hridaKun/esp32-fluorimeter/Simulation/Outputs/1_dc_transfer.png

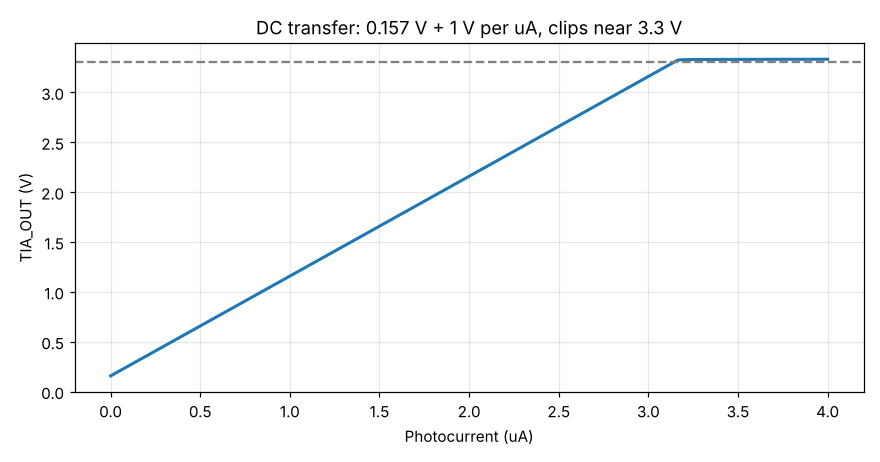
Simulation/Outputs/1_dc_transfer.png
