hridaKun/esp32-fluorimeter/Simulation/Outputs/2_led_pulse.png

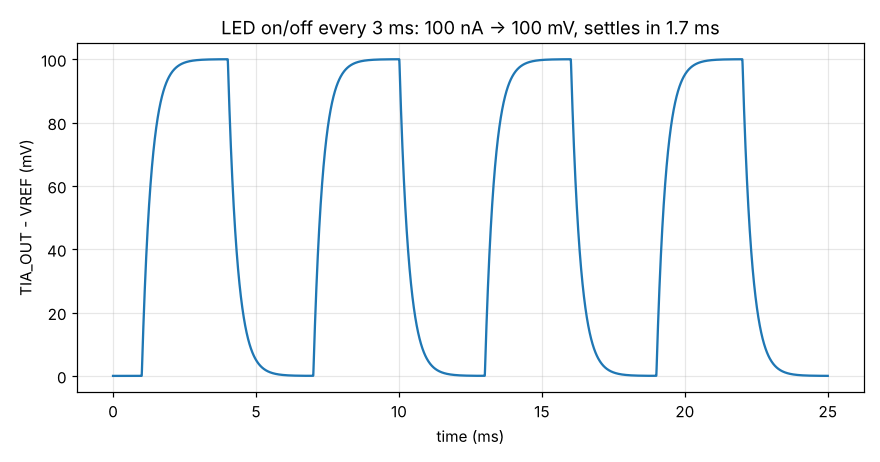
Simulation/Outputs/2_led_pulse.png
