hridaKun/esp32-fluorimeter/Simulation/Outputs/3_stability_noCf.png

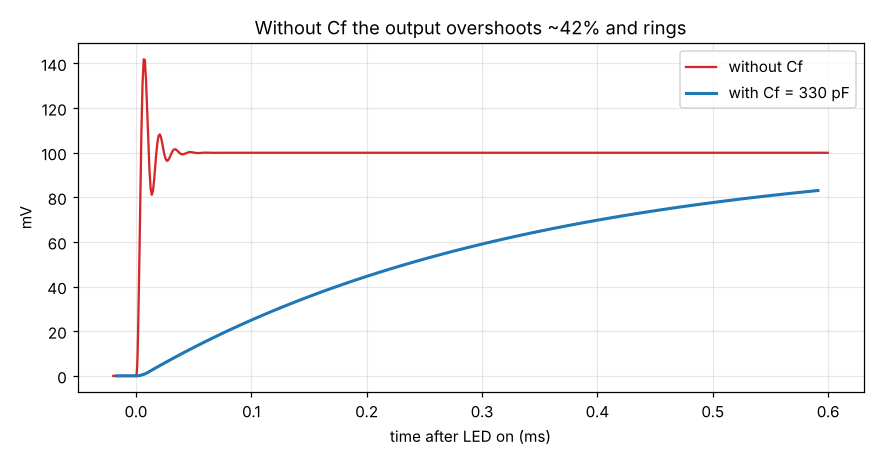
Simulation/Outputs/3_stability_noCf.png
