hridaKun/esp32-fluorimeter/docs/BOM.md

# Bill of Materials

| Ref | Qty | Part | Value / Type |
|---|---|---|---|
| U1 | 1 | ESP32 DevKit | 38-pin |
| U2 | 1 | Op-amp | MCP602, DIP-8 (with socket) |
| U3 | 1 | ADC module | ADS1115 breakout |
| J1 | 1 | Display | 2.4" ILI9341 SPI TFT |
| D1 | 1 | Photodiode | Vishay BPW34 |
| D2 | 1 | LED | Blue, 5 mm, ~470 nm |
| Q1 | 1 | NPN transistor | BC547 (C-B-E) |
| R1 | 1 | Resistor | 20 kΩ |
| R2 | 1 | Resistor | 1 kΩ |
| R3 | 1 | Resistor (Rf) | 1 MΩ, 1 % |
| R4 | 1 | Resistor | 100 Ω |
| R5 | 1 | Resistor | 1 kΩ |
| C1 | 1 | Capacitor | 10 µF |
| C2 | 1 | Capacitor (Cf) | 330 pF C0G (or 220 pF + 100 pF) |
| C3 | 1 | Capacitor | 100 nF ceramic |
| SW1, SW2 | 2 | Push button | 6 mm tactile |
| — | 1 | Emission filter | long-pass green/yellow (gel or glass) |
| — | — | Cuvettes | 10 mm, plastic |
| — | — | Test fluorophore | fluorescein sodium |
| — | — | Misc | female headers, breadboard/perfboard, wires |
