hridaKun/esp32-fluorimeter/Schematic/Circuit.pdf

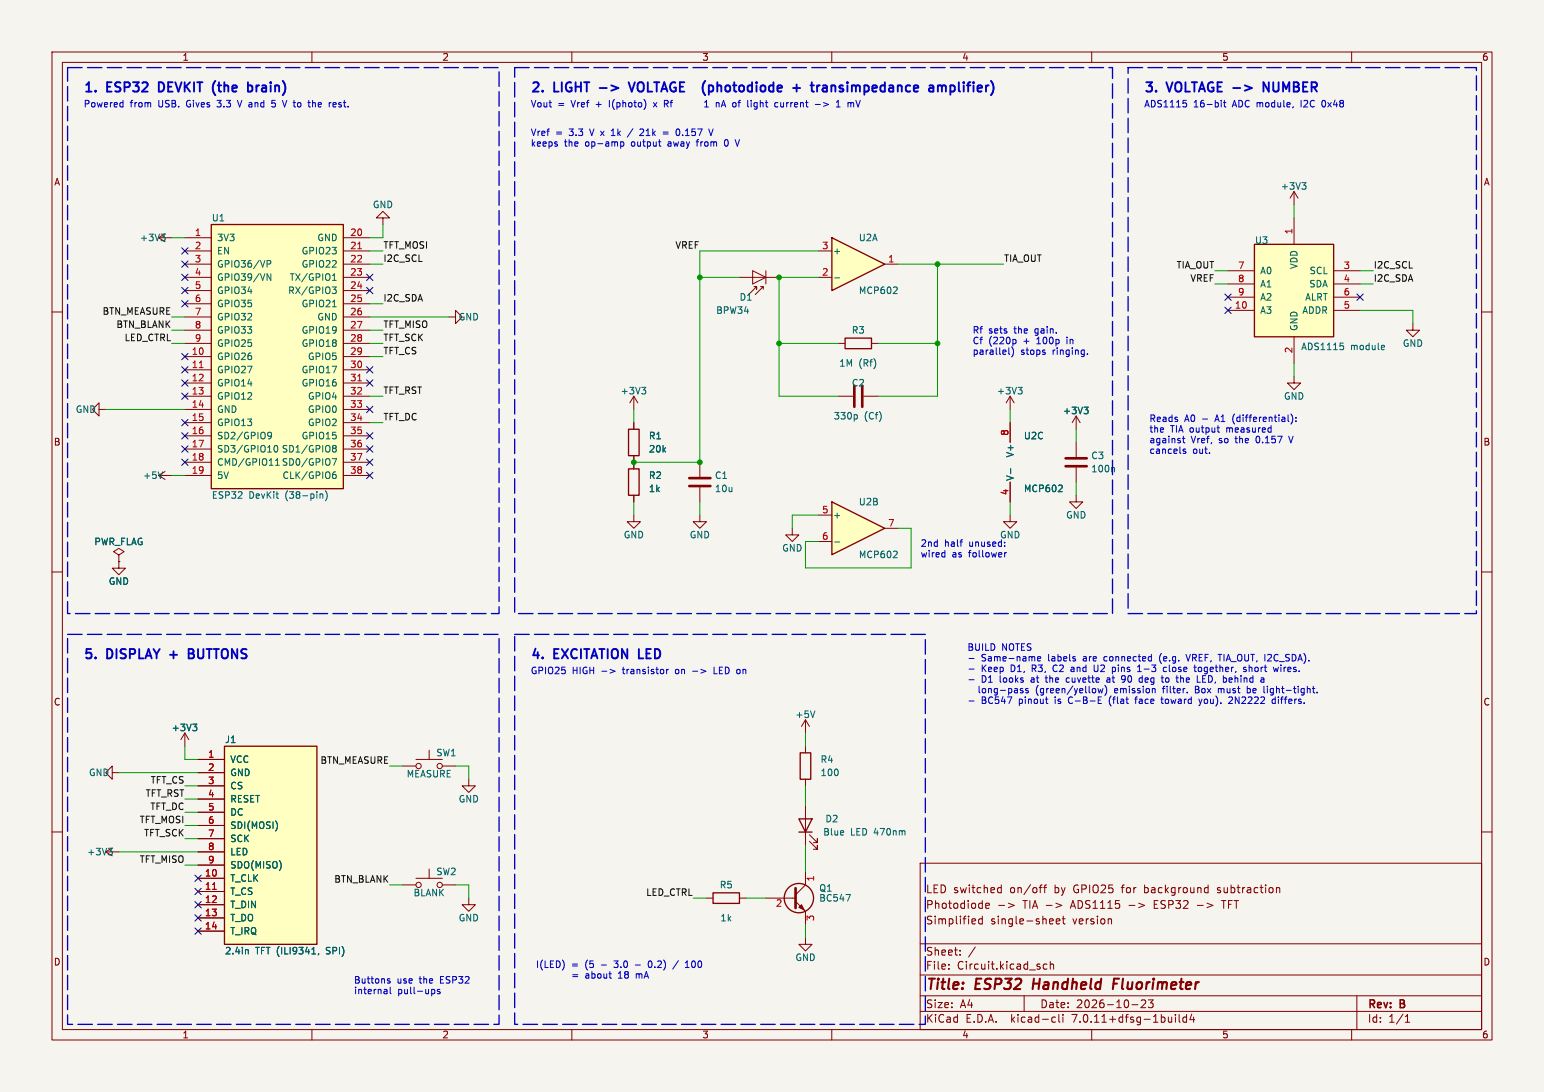
[picture p6: page 1]

2 SCL 3 SDA 4 ADDR 5 ALRT 6 A0 7 A1 8 A2 9 U3 ADS1115 module +3V3 VCC 1 T_CLK 10 T_CS 11 T_DIN 12 T_DO 13 T_IRQ 14 GND 2 CS 3 RESET 4 DC 5 SDI(MOSI) 6 SCK 7

2nd half unused: wired as follower Rf sets the gain. Cf (220p + 100p in

the TIA output measured
against Vref, so the 0.157 V
