hridaKun/esp32-fluorimeter/Schematic/Circuit.kicad_sch

## KiCad design Schematic/Circuit.kicad_sch (2026-10-23)

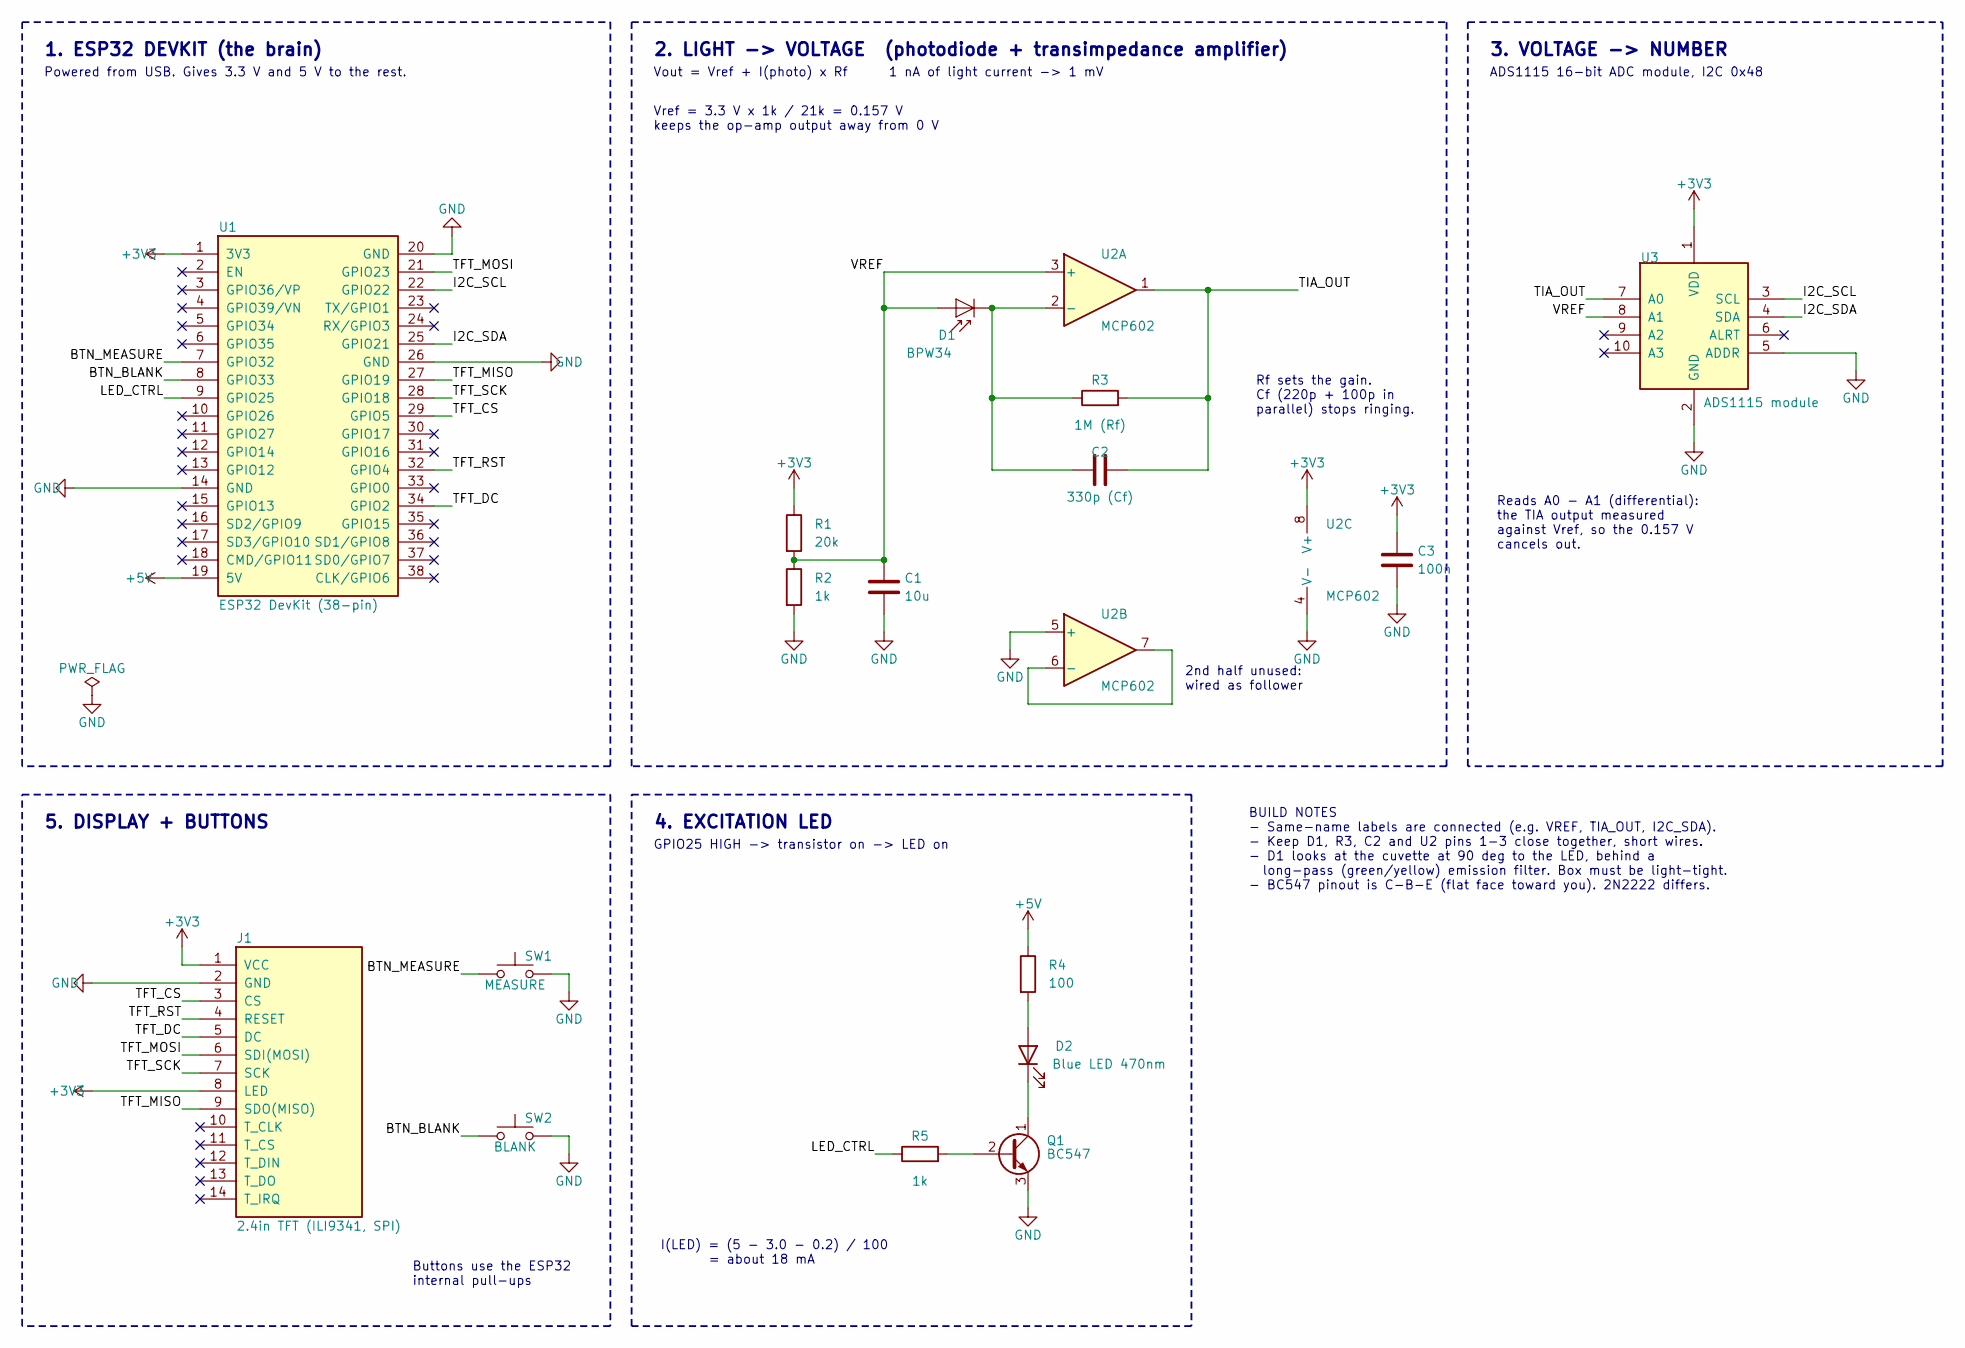
[picture p7: schematic Circuit.kicad_sch]

Parts:
C1: 10u; CP_Radial_D5.0mm_P2.00mm
C2: 330p (Cf); C_Disc_D5.0mm_W2.5mm_P5.00mm
C3: 100n; C_Disc_D5.0mm_W2.5mm_P5.00mm
D1: BPW34; Osram_DIL2_4.3x4.65mm_P5.08mm
D2: Blue LED 470nm; LED_D5.0mm
J1: 2.4in TFT (ILI9341, SPI)
Q1: BC547; TO-92_Inline
R1: 20k; R_Axial_DIN0207_L6.3mm_D2.5mm_P7.62mm_Horizontal
R2, R5: 1k; R_Axial_DIN0207_L6.3mm_D2.5mm_P7.62mm_Horizontal
R3: 1M (Rf); R_Axial_DIN0207_L6.3mm_D2.5mm_P7.62mm_Horizontal
R4: 100; R_Axial_DIN0207_L6.3mm_D2.5mm_P7.62mm_Horizontal
SW1: MEASURE; SW_PUSH_6mm
SW2: BLANK; SW_PUSH_6mm
U1: ESP32 DevKit (38-pin)
U2: MCP602; DIP-8_W7.62mm
U3: ADS1115 module

Connections:
+3V3: C3.1, J1.1 (VCC), J1.8 (LED), R1.1, U1.1 (3V3), U2.8 (V+), U3.1 (VDD)
+5V: R4.1, U1.19 (5V)
BTN_BLANK: SW2.1, U1.8 (GPIO33)
BTN_MEASURE: SW1.1, U1.7 (GPIO32)
GND: C1.2, C3.2, J1.2 (GND), Q1.3 (E), R2.2, SW1.2, SW2.2, U1.14 (GND), U1.20 (GND), U1.26 (GND), U2.4 (V-), U2.5 (+), U3.2 (GND), U3.5 (ADDR)
I2C_SCL: U1.22 (GPIO22), U3.3 (SCL)
I2C_SDA: U1.25 (GPIO21), U3.4 (SDA)
LED_CTRL: R5.1, U1.9 (GPIO25)
unnamed: C2.1, D1.1 (K), R3.1, U2.2 (-)
unnamed: D2.1 (K), Q1.1 (C)
unnamed: D2.2 (A), R4.2
unnamed: Q1.2 (B), R5.2
unnamed: U2.6 (-), U2.7
TFT_CS: J1.3 (CS), U1.29 (GPIO5)
TFT_DC: J1.5 (DC), U1.34 (GPIO2)
TFT_MISO: J1.9 (SDO(MISO)), U1.27 (GPIO19)
TFT_MOSI: J1.6 (SDI(MOSI)), U1.21 (GPIO23)
TFT_RST: J1.4 (RESET), U1.32 (GPIO4)
TFT_SCK: J1.7 (SCK), U1.28 (GPIO18)
TIA_OUT: C2.2, R3.2, U2.1, U3.7 (A0)
VREF: C1.1, D1.2 (A), R1.2, R2.1, U2.3 (+), U3.8 (A1)

Notes on the sheet:
1. ESP32 DEVKIT (the brain)
Powered from USB. Gives 3.3 V and 5 V to the rest.
2. LIGHT -> VOLTAGE (photodiode + transimpedance amplifier)
Vout = Vref + I(photo) x Rf 1 nA of light current -> 1 mV
Vref = 3.3 V x 1k / 21k = 0.157 V keeps the op-amp output away from 0 V
Rf sets the gain. Cf (220p + 100p in parallel) stops ringing.
2nd half unused: wired as follower
3. VOLTAGE -> NUMBER
ADS1115 16-bit ADC module, I2C 0x48
Reads A0 - A1 (differential): the TIA output measured against Vref, so the 0.157 V cancels out.
4. EXCITATION LED
GPIO25 HIGH -> transistor on -> LED on
I(LED) = (5 - 3.0 - 0.2) / 100 = about 18 mA
5. DISPLAY + BUTTONS
Buttons use the ESP32 internal pull-ups
BUILD NOTES - Same-name labels are connected (e.g. VREF, TIA_OUT, I2C_SDA). - Keep D1, R3, C2 and U2 pins 1-3 close together, short wires. - D1 looks at the cuvette at 90 deg to the LED, behind a long-pass (green/yellow) emission filter. Box must be light-tight. - BC547 pinout is C-B-E (flat face t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
